CamHaoHa/tracker_leader_follower/example-code/images/hc-sr04.png

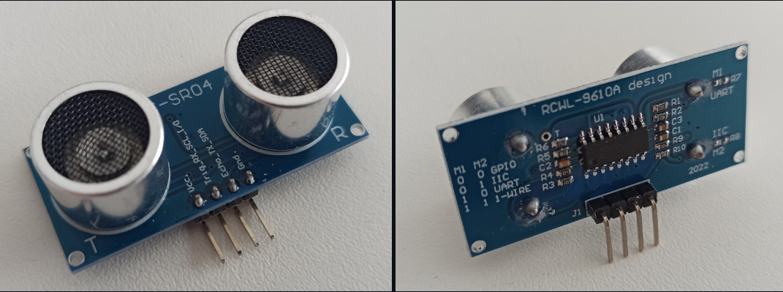
example-code/images/hc-sr04.png
