CamHaoHa/tracker_leader_follower/example-code/images/pico.png

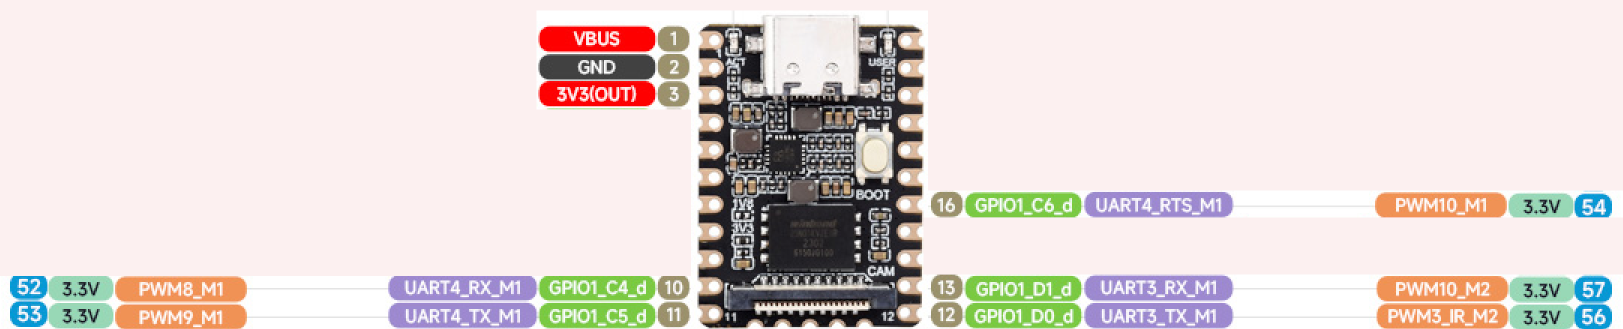
example-code/images/pico.png
