CamHaoHa/tracker_leader_follower/tools/README.md

# Sensor tools

## Prepare the Arduino IDE sketches

```bash
python3 -m tools.prepare_tracker_firmware
```

This writes one Arduino sketch folder per box position under
`firmware/arduino/`: `tracker_left`, `tracker_middle`, `tracker_right` and
`tracker_right_pair`. Each holds a copy of the maintained firmware and a private
`tracker_config.h`. Enter the phone hotspot's name and password there as
`WIFI_SSID` and `WIFI_PASSWORD`; the hotspot is the one supported network, so
there is no network option.

Running the command again refreshes the firmware copies and never overwrites an
existing `tracker_config.h`. Upload the sketches manually after any change. The
generator never connects to or flashes a board. Use `--check` to see whether the
generated files are current without writing anything.

See [live setup](../docs/live-tracker-setup.md) for joining the hotspot and
running the spot display.

## Record a real sensor test to Excel

Upload the Arduino `firmware/arduino/sensor_test/sensor_test.ino` sketch, then close
Serial Monitor and Serial Plotter. From the project root:

```bash
python3 -m tools.record_sensor_test --sensor A --distance-cm 25 --samples 30
```

This records USB serial measurements and saves a new timestamped folder under
`evidence/`, with an Excel report, CSV, original serial log, and metadata. The
distance argument is the measured true target gap, not a sensor command. See
[evidence instructions](../evidence/README.md) for port selection and partial runs.

## Jump benchmark (simulator)

```bash
python3 -m tools.jump_bench --csv results/jump-bench.csv --timeline
```

Times how fast the swarm tracker finds a player who jumps to another column, on
`config.prototype.json` in the built-in simulator: before the search after a
full loss, with it, and with a right or wrong `expect()` hint. It prints
Markdown tables (median, fastest and slowest of 20 jump moments); `--csv`
writes one row per trial and `--timeline` what each box does after one jump.
The numbers repeat exactly and say nothing about Wi-Fi delay or real echoes.
Recorded results: [jump benchmark, 2 October](../docs/jump-bench-2026-10-02.md).

## Standing benchmark (simulator)

```bash
python3 -m tools.stand_bench --csv results/stand-bench.csv
python3 -m tools.stand_bench --miss 0.3 --edge 0.6
```

How well the swarm tracker holds a player who stands still on each hole of
the game, in the field of 5 October 2026: that evening's arcs and empty-room
map, in which the outer boxes hear something about 0.6 m away (most likely
the middle box) at the inner ends of their arcs. The simulated boxes hear that
object where the map has it and, on some pings (`--edge`), up to 10 degrees
further in; and they miss the player on a share of pings (`--miss`). It
prints losses and cursor jumps per minute and the time on the hole for the
tracker before and after the change of 5 October. The echo model and both
rates are assumptions. Recorded results:
[standing benchmark, 5 October](../docs/stand-bench-2026-10-05.md).

## UDP sensor emulator

`simulate_nodes.py` runs two independent UDP endpoints with the same messages as the ESP32 firmware. Use it to exercise discovery, network acquisition, tracking, and disconnection without physical sensors:

```bash
python3 tools/simulate_nodes.py --x 0.75 --y 1.3 --seconds 60
```

The nodes bind `127.0.0.2:4211` and `127.0.0.3:4211`, and announce themselves to `127.0.0.1:4210`. Use the desktop application's normal hardware mode on the same computer; `--simulate` uses its separate in-process model and bypasses UDP. Run only one host and one copy of this emulator at a time.

The model uses sensors at `(0, 0.2)` and `(1.5, 0.2)` metres, 20° beam half angles, 60 ms + 3 ms/degree servo settling (maximum 700 ms), and bounded echo delay. It represents one ideal reflector and cannot establish real hardware accuracy or reliable detection of a moving person.

Options include `--empty` to return echo timeouts and `--drop-node 0` or `--drop-node 1` to suppress a node entirely. Ctrl+C stops the emulator. Its final JSON summary reports ping counts, the shortest interval between pings, and any overlapping acquisition commands.

The hardware path requires a background calibration. To exercise that workflow, start the emulator with `--empty --seconds 120`; in another terminal run:

```bash
python3 -m whack --headless --calibrate --seconds 90 --calibration /tmp/whack-udp-calibration.json
```

Stop the empty emulator, restart it with a reflector using the first command, then launch the visualizer with the same temporary profile:

```bash
python3 -m whack --calibration /tmp/whack-udp-calibration.json
```

Keep the simulator's profile separate from calibration captured with physical hardware. The temporary path above is suitable on Linux/macOS; choose a writable temporary path on Windows.

For an automated test, run:

```bash
python3 -m unittest discover -s tests -p 'test_udp.py' -v
```

The integration tests create their own temporary empty-scene profile, start the emulator as a subprocess, and verify discovery, position recovery, empty echoes, missing nodes, and expiration after disconnection. They use real loopback sockets; run outside a network-restricted sandbox if socket creation is denied.
