CamHaoHa/tracker_leader_follower/example-code/UPSTREAM.md

# Upstream provenance

This directory is a vendored, read-only copy of a third-party reference implementation.

- Upstream: https://github.com/themrleon/ultrasonic-2d-position-tracker
- Commit: 30b44d48dc3ab6ff51339cb5406505075d72c266 (2025-10-14T12:43:07-04:00)
- Licence: see LICENSE in this directory
- Vendored on: 2026-09-11

It is kept for study only. Do not modify files here; if changes are needed, copy the idea into this project's own code and cite the upstream file and line.
