CamHaoHa/tracker_leader_follower/example-code/images/demo.gif

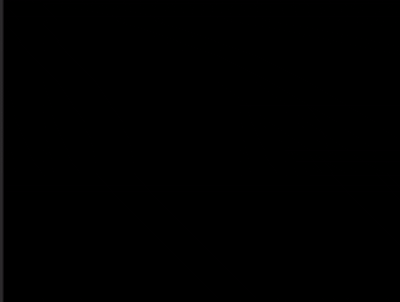
example-code/images/demo.gif
