CamHaoHa/tracker_leader_follower/results/report/reacquire_histogram.png

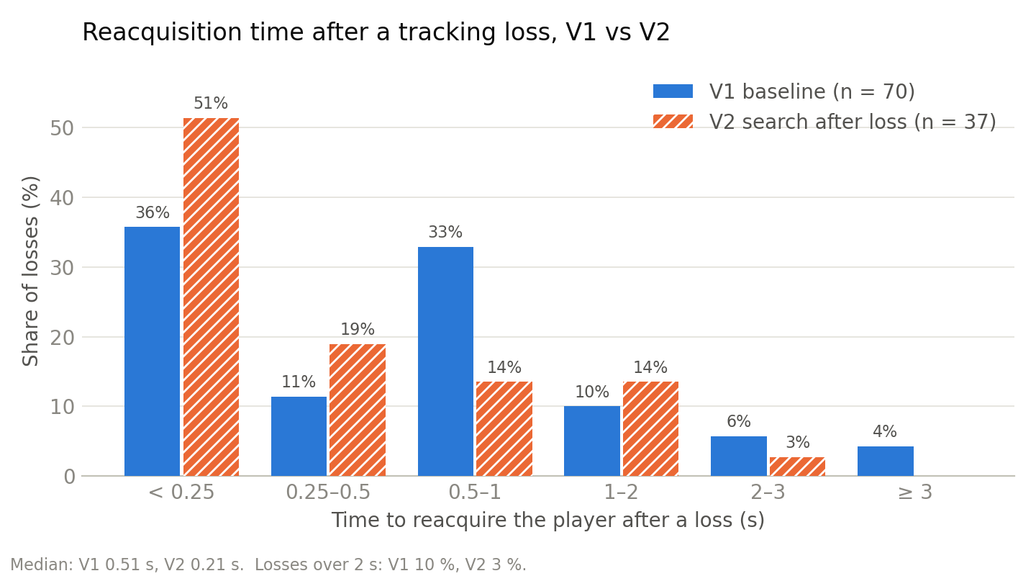
results/report/reacquire_histogram.png
