CamHaoHa/tracker_leader_follower/evidence/20260914_215239_sensor-A_25cm_32d13e63/results.xlsx

Sheet: Summary
Measure | Result
sensor | A
true_distance_cm | 25
requested_attempts | 30
started_at | 2026-09-14T21:52:39.410794+10:00
port | /dev/ttyUSB0
baud | 115200
capture_timeout_s | 60
startup_excluded_s | 2
notes
recorder_sha256 | a97a6e3836788a9964c5fdaa4a6315613b1148c47cfca23bae7fcd65e1e4d26a
uploaded_firmware | Not verified over serial; use Arduino sensor_test sketch.
finished_at | 2026-09-14T21:53:39.462816+10:00
capture_status | timeout
recorded_attempts | 0
numerical_returns | 0
no_echo | 0
echo_high | 0
out_of_range | 0
malformed | 0
return_rate
mean_cm
bias_cm
sample_sd_cm
min_cm
max_cm
mean_absolute_error_cm
Interpretation | Capture completion is not a reliability pass. Numerical returns may still be inaccurate.
Statistics | Statistics use READING rows only. Error statuses remain in the attempt counts and raw evidence.
Range filtering | This recorder does not impose a distance cap. OUT OF RANGE comes from the uploaded sketch.
Calibration | Bias is measured minus true distance. No correction is applied to the readings.
Raw evidence | serial.log preserves bytes received during capture; the final chunk can include extra uncounted lines.

Sheet: Readings
Sample | Received at | Status | Reading (cm) | True distance (cm) | Bias (cm) | Absolute error (cm) | Original serial line
