CamHaoHa/tracker_leader_follower/evidence/20260914_215543_sensor-A_25cm_cd1e33df/results.xlsx

Sheet: Summary
Measure | Result
sensor | A
true_distance_cm | 25
requested_attempts | 30
started_at | 2026-09-14T21:55:43.074206+10:00
port | /dev/ttyUSB0
baud | 115200
capture_timeout_s | 60
startup_excluded_s | 2
notes
recorder_sha256 | a97a6e3836788a9964c5fdaa4a6315613b1148c47cfca23bae7fcd65e1e4d26a
uploaded_firmware | Not verified over serial; use Arduino sensor_test sketch.
finished_at | 2026-09-14T21:55:58.094595+10:00
capture_status | complete
recorded_attempts | 30
numerical_returns | 30
no_echo | 0
echo_high | 0
out_of_range | 0
malformed | 0
return_rate | 1
mean_cm | 25.36333333
bias_cm | 0.3633333333
sample_sd_cm | 0.4055505694
min_cm | 24.5
max_cm | 26.3
mean_absolute_error_cm | 0.43
Interpretation | Capture completion is not a reliability pass. Numerical returns may still be inaccurate.
Statistics | Statistics use READING rows only. Error statuses remain in the attempt counts and raw evidence.
Range filtering | This recorder does not impose a distance cap. OUT OF RANGE comes from the uploaded sketch.
Calibration | Bias is measured minus true distance. No correction is applied to the readings.
Raw evidence | serial.log preserves bytes received during capture; the final chunk can include extra uncounted lines.

Sheet: Readings
Sample | Received at | Status | Reading (cm) | True distance (cm) | Bias (cm) | Absolute error (cm) | Original serial line
1 | 2026-09-14T21:55:43.325044+10:00 | READING | 25.10 | 25.00 | 0.10 | 0.10 | Distance: 25.1 cm | echo: 1466 us
2 | 2026-09-14T21:55:43.825805+10:00 | READING | 25.10 | 25.00 | 0.10 | 0.10 | Distance: 25.1 cm | echo: 1466 us
3 | 2026-09-14T21:55:44.326459+10:00 | READING | 24.60 | 25.00 | -0.40 | 0.40 | Distance: 24.6 cm | echo: 1432 us
4 | 2026-09-14T21:55:44.827020+10:00 | READING | 24.50 | 25.00 | -0.50 | 0.50 | Distance: 24.5 cm | echo: 1431 us
5 | 2026-09-14T21:55:45.327687+10:00 | READING | 25.50 | 25.00 | 0.50 | 0.50 | Distance: 25.5 cm | echo: 1484 us
6 | 2026-09-14T21:55:45.828469+10:00 | READING | 24.90 | 25.00 | -0.10 | 0.10 | Distance: 24.9 cm | echo: 1449 us
7 | 2026-09-14T21:55:46.329096+10:00 | READING | 26.30 | 25.00 | 1.30 | 1.30 | Distance: 26.3 cm | echo: 1536 us
8 | 2026-09-14T21:55:46.829464+10:00 | READING | 25.40 | 25.00 | 0.40 | 0.40 | Distance: 25.4 cm | echo: 1483 us
9 | 2026-09-14T21:55:47.329940+10:00 | READING | 25.50 | 25.00 | 0.50 | 0.50 | Distance: 25.5 cm | echo: 1484 us
10 | 2026-09-14T21:55:47.830552+10:00 | READING | 25.40 | 25.00 | 0.40 | 0.40 | Distance: 25.4 cm | echo: 1483 us
11 | 2026-09-14T21:55:48.331180+10:00 | READING | 25.50 | 25.00 | 0.50 | 0.50 | Distance: 25.5 cm | echo: 1484 us
12 | 2026-09-14T21:55:48.831776+10:00 | READING | 25.40 | 25.00 | 0.40 | 0.40 | Distance: 25.4 cm | echo: 1483 us
13 | 2026-09-14T21:55:49.332440+10:00 | READING | 25.50 | 25.00 | 0.50 | 0.50 | Distance: 25.5 cm | echo: 1484 us
14 | 2026-09-14T21:55:49.833106+10:00 | READING | 25.40 | 25.00 | 0.40 | 0.40 | Distance: 25.4 cm | echo: 1483 us
15 | 2026-09-14T21:55:50.333799+10:00 | READING | 26.00 | 25.00 | 1.00 | 1.00 | Distance: 26.0 cm | echo: 1518 us
16 | 2026-09-14T21:55:50.834433+10:00 | READING | 25.40 | 25.00 | 0.40 | 0.40 | Distance: 25.4 cm | echo: 1483 us
17 | 2026-09-14T21:55:51.335076+10:00 | READING | 25.50 | 25.00 | 0.50 | 0.50 | Distance: 25.5 cm | echo: 1484 us
18 | 2026-09-14T21:55:51.835631+10:00 | READING | 25.50 | 25.00 | 0.50 | 0.50 | Distance: 25.5 cm | echo: 1484 us
19 | 2026-09-14T21:55:52.336195+10:00 | READING | 26.00 | 25.00 | 1.00 | 1.00 | Distance: 26.0 cm | echo: 1518 us
20 | 2026-09-14T21:55:52.836753+10:00 | READING | 25.10 | 25.00 | 0.10 | 0.10 | Distance: 25.1 cm | echo: 1466 us
21 | 2026-09-14T21:55:53.337262+10:00 | READING | 25.20 | 25.00 | 0.20 | 0.20 | Distance: 25.2 cm | echo: 1467 us
22 | 2026-09-14T21:55:53.837999+10:00 | READING | 25.10 | 25.00 | 0.10 | 0.10 | Distance: 25.1 cm | echo: 1466 us
23 | 2026-09-14T21:55:54.338517+10:00 | READING | 25.10 | 25.00 | 0.10 | 0.10 | Distance: 25.1 cm | echo: 1466 us
24 | 2026-09-14T21:55:55.089676+10:00 | READING | 25.10 | 25.00 | 0.10 | 0.10 | Distance: 25.1 cm | echo: 1466 us
25 | 2026-09-14T21:55:55.590456+10:00 | READING | 25.20 | 25.00 | 0.20 | 0.20 | Distance: 25.2 cm | echo: 1467 us
26 | 2026-09-14T21:55:56.091230+10:00 | READING | 25.10 | 25.00 | 0.10 | 0.10 | Distance: 25.1 cm | echo: 1466 us
27 | 2026-09-14T21:55:56.591987+10:00 | READING | 25.10 | 25.00 | 0.10 | 0.10 | Distance: 25.1 cm | echo: 1466 us
28 | 2026-09-14T21:55:57.092809+10:00 | READING | 26.00 | 25.00 | 1.00 | 1.00 | Distance: 26.0 cm | echo: 1518 us
29 | 2026-09-14T21:55:57.593654+10:00 | READING | 25.40 | 25.00 | 0.40 | 0.40 | Distance: 25.4 cm | echo: 1483 us
30 | 2026-09-14T21:55:58.094528+10:00 | READING | 26.00 | 25.00 | 1.00 | 1.00 | Distance: 26.0 cm | echo: 1518 us
