CamHaoHa/tracker_leader_follower/evidence/20260914_215833_sensor-A_50cm_f1ec5aa8/results.xlsx

Sheet: Summary
Measure | Result
sensor | A
true_distance_cm | 50
requested_attempts | 30
started_at | 2026-09-14T21:58:33.720782+10:00
port | /dev/ttyUSB0
baud | 115200
capture_timeout_s | 60
startup_excluded_s | 2
notes
recorder_sha256 | a97a6e3836788a9964c5fdaa4a6315613b1148c47cfca23bae7fcd65e1e4d26a
uploaded_firmware | Not verified over serial; use Arduino sensor_test sketch.
finished_at | 2026-09-14T21:58:48.747902+10:00
capture_status | complete
recorded_attempts | 30
numerical_returns | 30
no_echo | 0
echo_high | 0
out_of_range | 0
malformed | 0
return_rate | 1
mean_cm | 54.62666667
bias_cm | 4.626666667
sample_sd_cm | 7.019722626
min_cm | 48
max_cm | 68
mean_absolute_error_cm | 5.373333333
Interpretation | Capture completion is not a reliability pass. Numerical returns may still be inaccurate.
Statistics | Statistics use READING rows only. Error statuses remain in the attempt counts and raw evidence.
Range filtering | This recorder does not impose a distance cap. OUT OF RANGE comes from the uploaded sketch.
Calibration | Bias is measured minus true distance. No correction is applied to the readings.
Raw evidence | serial.log preserves bytes received during capture; the final chunk can include extra uncounted lines.

Sheet: Readings
Sample | Received at | Status | Reading (cm) | True distance (cm) | Bias (cm) | Absolute error (cm) | Original serial line
1 | 2026-09-14T21:58:33.978423+10:00 | READING | 67.60 | 50.00 | 17.60 | 17.60 | Distance: 67.6 cm | echo: 3941 us
2 | 2026-09-14T21:58:34.479001+10:00 | READING | 67.20 | 50.00 | 17.20 | 17.20 | Distance: 67.2 cm | echo: 3916 us
3 | 2026-09-14T21:58:34.979514+10:00 | READING | 67.20 | 50.00 | 17.20 | 17.20 | Distance: 67.2 cm | echo: 3917 us
4 | 2026-09-14T21:58:35.480045+10:00 | READING | 67.20 | 50.00 | 17.20 | 17.20 | Distance: 67.2 cm | echo: 3916 us
5 | 2026-09-14T21:58:35.980625+10:00 | READING | 68.00 | 50.00 | 18.00 | 18.00 | Distance: 68.0 cm | echo: 3964 us
6 | 2026-09-14T21:58:36.481329+10:00 | READING | 63.40 | 50.00 | 13.40 | 13.40 | Distance: 63.4 cm | echo: 3698 us
7 | 2026-09-14T21:58:36.981866+10:00 | READING | 60.70 | 50.00 | 10.70 | 10.70 | Distance: 60.7 cm | echo: 3538 us
8 | 2026-09-14T21:58:37.482458+10:00 | READING | 59.00 | 50.00 | 9.00 | 9.00 | Distance: 59.0 cm | echo: 3438 us
9 | 2026-09-14T21:58:37.983091+10:00 | READING | 57.50 | 50.00 | 7.50 | 7.50 | Distance: 57.5 cm | echo: 3355 us
10 | 2026-09-14T21:58:38.483721+10:00 | READING | 56.60 | 50.00 | 6.60 | 6.60 | Distance: 56.6 cm | echo: 3298 us
11 | 2026-09-14T21:58:38.984347+10:00 | READING | 55.00 | 50.00 | 5.00 | 5.00 | Distance: 55.0 cm | echo: 3206 us
12 | 2026-09-14T21:58:39.484917+10:00 | READING | 54.80 | 50.00 | 4.80 | 4.80 | Distance: 54.8 cm | echo: 3196 us
13 | 2026-09-14T21:58:39.985611+10:00 | READING | 53.40 | 50.00 | 3.40 | 3.40 | Distance: 53.4 cm | echo: 3115 us
14 | 2026-09-14T21:58:40.486308+10:00 | READING | 51.50 | 50.00 | 1.50 | 1.50 | Distance: 51.5 cm | echo: 3003 us
15 | 2026-09-14T21:58:40.986938+10:00 | READING | 50.30 | 50.00 | 0.30 | 0.30 | Distance: 50.3 cm | echo: 2931 us
16 | 2026-09-14T21:58:41.487450+10:00 | READING | 50.30 | 50.00 | 0.30 | 0.30 | Distance: 50.3 cm | echo: 2932 us
17 | 2026-09-14T21:58:42.238632+10:00 | READING | 49.40 | 50.00 | -0.60 | 0.60 | Distance: 49.4 cm | echo: 2883 us
18 | 2026-09-14T21:58:42.739360+10:00 | READING | 49.00 | 50.00 | -1.00 | 1.00 | Distance: 49.0 cm | echo: 2860 us
19 | 2026-09-14T21:58:43.240029+10:00 | READING | 49.80 | 50.00 | -0.20 | 0.20 | Distance: 49.8 cm | echo: 2906 us
20 | 2026-09-14T21:58:43.740723+10:00 | READING | 50.30 | 50.00 | 0.30 | 0.30 | Distance: 50.3 cm | echo: 2931 us
21 | 2026-09-14T21:58:44.241440+10:00 | READING | 49.00 | 50.00 | -1.00 | 1.00 | Distance: 49.0 cm | echo: 2860 us
22 | 2026-09-14T21:58:44.742216+10:00 | READING | 49.50 | 50.00 | -0.50 | 0.50 | Distance: 49.5 cm | echo: 2884 us
23 | 2026-09-14T21:58:45.242766+10:00 | READING | 48.60 | 50.00 | -1.40 | 1.40 | Distance: 48.6 cm | echo: 2835 us
24 | 2026-09-14T21:58:45.743451+10:00 | READING | 49.40 | 50.00 | -0.60 | 0.60 | Distance: 49.4 cm | echo: 2883 us
25 | 2026-09-14T21:58:46.244219+10:00 | READING | 48.00 | 50.00 | -2.00 | 2.00 | Distance: 48.0 cm | echo: 2800 us
26 | 2026-09-14T21:58:46.744681+10:00 | READING | 48.60 | 50.00 | -1.40 | 1.40 | Distance: 48.6 cm | echo: 2835 us
27 | 2026-09-14T21:58:47.245471+10:00 | READING | 49.40 | 50.00 | -0.60 | 0.60 | Distance: 49.4 cm | echo: 2883 us
28 | 2026-09-14T21:58:47.746185+10:00 | READING | 49.20 | 50.00 | -0.80 | 0.80 | Distance: 49.2 cm | echo: 2871 us
29 | 2026-09-14T21:58:48.247013+10:00 | READING | 49.90 | 50.00 | -0.10 | 0.10 | Distance: 49.9 cm | echo: 2907 us
30 | 2026-09-14T21:58:48.747837+10:00 | READING | 49.00 | 50.00 | -1.00 | 1.00 | Distance: 49.0 cm | echo: 2859 us
