CamHaoHa/tracker_leader_follower/results/sensor-test-results.xlsx

Sheet: Read me
HC-SR04 sensor test results
Started | 2026-09-14
Current result | Sensor A: 25 cm recorded; first 50 cm run recorded but unstable (68 down to about 49 cm). Repeat fixed-target 50 cm run before calibration.
Purpose | Record accuracy, repeatability and missing readings for two sensors.
Hardware | Freenove ESP32-WROOM-32E; HC-SR04; TRIG GPIO32; ECHO GPIO35 through resistor divider.
Setup | One sensor active at a time, servo unpowered, sensor fixed and flat target facing it squarely.
True distance | Measure from front faces of metal transducers to target. All distances in centimetres.
Plan | Sensors A and B; 25, 50, 100, 150, 200 cm; 30 consecutive attempts at each distance.
Raw readings | Pre-filled IDs and sample numbers are planned slots, not completed measurements. Empty measurement cells mean no data.
Enter readings | Enter numerical distance in column E and READING in column F. Record errors in F with E blank.
Error statuses | NO ECHO; ECHO HIGH; OUT OF RANGE; OTHER ERROR. Preserve full serial messages in Notes.
Summary | Formulas calculate when opened in Excel. Numerical returns are not automatically accurate readings.
Statistics | Bias = measured minus true; MAE = average absolute error; SD = sample standard deviation.
Limits | No pass/fail threshold agreed. Flat-target tests do not establish body-tracking or servo-system reliability.
Conditions to record | Test date/time, sensor identity, supply voltage if measured, target dimensions, room temperature if known, resets.
Firmware | Updated sensor_test.ino: accepts 2-200 cm; rejected echoes report OUT OF RANGE. 115200 baud. Upload required.
Evidence | Raw runs retained under evidence/: 25 cm at 21:55:43; 50 cm at 21:58:33; earlier empty capture at 21:52:39.

Sheet: Raw readings
Test ID | Sensor | True distance (cm) | Sample | Reading (cm) | Status | Bias (cm) | Absolute error (cm) | Notes / original serial line
A-25-run1 | A | 25 | 1 | 25.10 | READING |  |  | 2026-09-14T21:55:43.325044+10:00 | Distance: 25.1 cm | echo: 1466 us | Source: 20260914_215543_sensor-A_25cm_cd1e33df
A-25-run1 | A | 25 | 2 | 25.10 | READING |  |  | 2026-09-14T21:55:43.825805+10:00 | Distance: 25.1 cm | echo: 1466 us | Source: 20260914_215543_sensor-A_25cm_cd1e33df
A-25-run1 | A | 25 | 3 | 24.60 | READING |  |  | 2026-09-14T21:55:44.326459+10:00 | Distance: 24.6 cm | echo: 1432 us | Source: 20260914_215543_sensor-A_25cm_cd1e33df
A-25-run1 | A | 25 | 4 | 24.50 | READING |  |  | 2026-09-14T21:55:44.827020+10:00 | Distance: 24.5 cm | echo: 1431 us | Source: 20260914_215543_sensor-A_25cm_cd1e33df
A-25-run1 | A | 25 | 5 | 25.50 | READING |  |  | 2026-09-14T21:55:45.327687+10:00 | Distance: 25.5 cm | echo: 1484 us | Source: 20260914_215543_sensor-A_25cm_cd1e33df
A-25-run1 | A | 25 | 6 | 24.90 | READING |  |  | 2026-09-14T21:55:45.828469+10:00 | Distance: 24.9 cm | echo: 1449 us | Source: 20260914_215543_sensor-A_25cm_cd1e33df
A-25-run1 | A | 25 | 7 | 26.30 | READING |  |  | 2026-09-14T21:55:46.329096+10:00 | Distance: 26.3 cm | echo: 1536 us | Source: 20260914_215543_sensor-A_25cm_cd1e33df
A-25-run1 | A | 25 | 8 | 25.40 | READING |  |  | 2026-09-14T21:55:46.829464+10:00 | Distance: 25.4 cm | echo: 1483 us | Source: 20260914_215543_sensor-A_25cm_cd1e33df
A-25-run1 | A | 25 | 9 | 25.50 | READING |  |  | 2026-09-14T21:55:47.329940+10:00 | Distance: 25.5 cm | echo: 1484 us | Source: 20260914_215543_sensor-A_25cm_cd1e33df
A-25-run1 | A | 25 | 10 | 25.40 | READING |  |  | 2026-09-14T21:55:47.830552+10:00 | Distance: 25.4 cm | echo: 1483 us | Source: 20260914_215543_sensor-A_25cm_cd1e33df
A-25-run1 | A | 25 | 11 | 25.50 | READING |  |  | 2026-09-14T21:55:48.331180+10:00 | Distance: 25.5 cm | echo: 1484 us | Source: 20260914_215543_sensor-A_25cm_cd1e33df
A-25-run1 | A | 25 | 12 | 25.40 | READING |  |  | 2026-09-14T21:55:48.831776+10:00 | Distance: 25.4 cm | echo: 1483 us | Source: 20260914_215543_sensor-A_25cm_cd1e33df
A-25-run1 | A | 25 | 13 | 25.50 | READING |  |  | 2026-09-14T21:55:49.332440+10:00 | Distance: 25.5 cm | echo: 1484 us | Source: 20260914_215543_sensor-A_25cm_cd1e33df
A-25-run1 | A | 25 | 14 | 25.40 | READING |  |  | 2026-09-14T21:55:49.833106+10:00 | Distance: 25.4 cm | echo: 1483 us | Source: 20260914_215543_sensor-A_25cm_cd1e33df
A-25-run1 | A | 25 | 15 | 26.00 | READING |  |  | 2026-09-14T21:55:50.333799+10:00 | Distance: 26.0 cm | echo: 1518 us | Source: 20260914_215543_sensor-A_25cm_cd1e33df
A-25-run1 | A | 25 | 16 | 25.40 | READING |  |  | 2026-09-14T21:55:50.834433+10:00 | Distance: 25.4 cm | echo: 1483 us | Source: 20260914_215543_sensor-A_25cm_cd1e33df
A-25-run1 | A | 25 | 17 | 25.50 | READING |  |  | 2026-09-14T21:55:51.335076+10:00 | Distance: 25.5 cm | echo: 1484 us | Source: 20260914_215543_sensor-A_25cm_cd1e33df
A-25-run1 | A | 25 | 18 | 25.50 | READING |  |  | 2026-09-14T21:55:51.835631+10:00 | Distance: 25.5 cm | echo: 1484 us | Source: 20260914_215543_sensor-A_25cm_cd1e33df
A-25-run1 | A | 25 | 19 | 26.00 | READING |  |  | 2026-09-14T21:55:52.336195+10:00 | Distance: 26.0 cm | echo: 1518 us | Source: 20260914_215543_sensor-A_25cm_cd1e33df
A-25-run1 | A | 25 | 20 | 25.10 | READING |  |  | 2026-09-14T21:55:52.836753+10:00 | Distance: 25.1 cm | echo: 1466 us | Source: 20260914_215543_sensor-A_25cm_cd1e33df
A-25-run1 | A | 25 | 21 | 25.20 | READING |  |  | 2026-09-14T21:55:53.337262+10:00 | Distance: 25.2 cm | echo: 1467 us | Source: 20260914_215543_sensor-A_25cm_cd1e33df
A-25-run1 | A | 25 | 22 | 25.10 | READING |  |  | 2026-09-14T21:55:53.837999+10:00 | Distance: 25.1 cm | echo: 1466 us | Source: 20260914_215543_sensor-A_25cm_cd1e33df
A-25-run1 | A | 25 | 23 | 25.10 | READING |  |  | 2026-09-14T21:55:54.338517+10:00 | Distance: 25.1 cm | echo: 1466 us | Source: 20260914_215543_sensor-A_25cm_cd1e33df
A-25-run1 | A | 25 | 24 | 25.10 | READING |  |  | 2026-09-14T21:55:55.089676+10:00 | Distance: 25.1 cm | echo: 1466 us | Source: 20260914_215543_sensor-A_25cm_cd1e33df
A-25-run1 | A | 25 | 25 | 25.20 | READING |  |  | 2026-09-14T21:55:55.590456+10:00 | Distance: 25.2 cm | echo: 1467 us | Source: 20260914_215543_sensor-A_25cm_cd1e33df
A-25-run1 | A | 25 | 26 | 25.10 | READING |  |  | 2026-09-14T21:55:56.091230+10:00 | Distance: 25.1 cm | echo: 1466 us | Source: 20260914_215543_sensor-A_25cm_cd1e33df
A-25-run1 | A | 25 | 27 | 25.10 | READING |  |  | 2026-09-14T21:55:56.591987+10:00 | Distance: 25.1 cm | echo: 1466 us | Source: 20260914_215543_sensor-A_25cm_cd1e33df
A-25-run1 | A | 25 | 28 | 26.00 | READING |  |  | 2026-09-14T21:55:57.092809+10:00 | Distance: 26.0 cm | echo: 1518 us | Source: 20260914_215543_sensor-A_25cm_cd1e33df
A-25-run1 | A | 25 | 29 | 25.40 | READING |  |  | 2026-09-14T21:55:57.593654+10:00 | Distance: 25.4 cm | echo: 1483 us | Source: 20260914_215543_sensor-A_25cm_cd1e33df
A-25-run1 | A | 25 | 30 | 26.00 | READING |  |  | 2026-09-14T21:55:58.094528+10:00 | Distance: 26.0 cm | echo: 1518 us | Source: 20260914_215543_sensor-A_25cm_cd1e33df
A-50-run1 | A | 50 | 1 | 67.60 | READING |  |  | 2026-09-14T21:58:33.978423+10:00 | Distance: 67.6 cm | echo: 3941 us | Source: 20260914_215833_sensor-A_50cm_f1ec5aa8
A-50-run1 | A | 50 | 2 | 67.20 | READING |  |  | 2026-09-14T21:58:34.479001+10:00 | Distance: 67.2 cm | echo: 3916 us | Source: 20260914_215833_sensor-A_50cm_f1ec5aa8
A-50-run1 | A | 50 | 3 | 67.20 | READING |  |  | 2026-09-14T21:58:34.979514+10:00 | Distance: 67.2 cm | echo: 3917 us | Source: 20260914_215833_sensor-A_50cm_f1ec5aa8
A-50-run1 | A | 50 | 4 | 67.20 | READING |  |  | 2026-09-14T21:58:35.480045+10:00 | Distance: 67.2 cm | echo: 3916 us | Source: 20260914_215833_sensor-A_50cm_f1ec5aa8
A-50-run1 | A | 50 | 5 | 68.00 | READING |  |  | 2026-09-14T21:58:35.980625+10:00 | Distance: 68.0 cm | echo: 3964 us | Source: 20260914_215833_sensor-A_50cm_f1ec5aa8
A-50-run1 | A | 50 | 6 | 63.40 | READING |  |  | 2026-09-14T21:58:36.481329+10:00 | Distance: 63.4 cm | echo: 3698 us | Source: 20260914_215833_sensor-A_50cm_f1ec5aa8
A-50-run1 | A | 50 | 7 | 60.70 | READING |  |  | 2026-09-14T21:58:36.981866+10:00 | Distance: 60.7 cm | echo: 3538 us | Source: 20260914_215833_sensor-A_50cm_f1ec5aa8
A-50-run1 | A | 50 | 8 | 59.00 | READING |  |  | 2026-09-14T21:58:37.482458+10:00 | Distance: 59.0 cm | echo: 3438 us | Source: 20260914_215833_sensor-A_50cm_f1ec5aa8
A-50-run1 | A | 50 | 9 | 57.50 | READING |  |  | 2026-09-14T21:58:37.983091+10:00 | Distance: 57.5 cm | echo: 3355 us | Source: 20260914_215833_sensor-A_50cm_f1ec5aa8
A-50-run1 | A | 50 | 10 | 56.60 | READING |  |  | 2026-09-14T21:58:38.483721+10:00 | Distance: 56.6 cm | echo: 3298 us | Source: 20260914_215833_sensor-A_50cm_f1ec5aa8
A-50-run1 | A | 50 | 11 | 55.00 | READING |  |  | 2026-09-14T21:58:38.984347+10:00 | Distance: 55.0 cm | echo: 3206 us | Source: 20260914_215833_sensor-A_50cm_f1ec5aa8
A-50-run1 | A | 50 | 12 | 54.80 | READING |  |  | 2026-09-14T21:58:39.484917+10:00 | Distance: 54.8 cm | echo: 3196 us | Source: 20260914_215833_sensor-A_50cm_f1ec5aa8
A-50-run1 | A | 50 | 13 | 53.40 | READING |  |  | 2026-09-14T21:58:39.985611+10:00 | Distance: 53.4 cm | echo: 3115 us | Source: 20260914_215833_sensor-A_50cm_f1ec5aa8
A-50-run1 | A | 50 | 14 | 51.50 | READING |  |  | 2026-09-14T21:58:40.486308+10:00 | Distance: 51.5 cm | echo: 3003 us | Source: 20260914_215833_sensor-A_50cm_f1ec5aa8
A-50-run1 | A | 50 | 15 | 50.30 | READING |  |  | 2026-09-14T21:58:40.986938+10:00 | Distance: 50.3 cm | echo: 2931 us | Source: 20260914_215833_sensor-A_50cm_f1ec5aa8
A-50-run1 | A | 50 | 16 | 50.30 | READING |  |  | 2026-09-14T21:58:41.487450+10:00 | Distance: 50.3 cm | echo: 2932 us | Source: 20260914_215833_sensor-A_50cm_f1ec5aa8
A-50-run1 | A | 50 | 17 | 49.40 | READING |  |  | 2026-09-14T21:58:42.238632+10:00 | Distance: 49.4 cm | echo: 2883 us | Source: 20260914_215833_sensor-A_50cm_f1ec5aa8
A-50-run1 | A | 50 | 18 | 49.00 | READING |  |  | 2026-09-14T21:58:42.739360+10:00 | Distance: 49.0 cm | echo: 2860 us | Source: 20260914_215833_sensor-A_50cm_f1ec5aa8
A-50-run1 | A | 50 | 19 | 49.80 | READING |  |  | 2026-09-14T21:58:43.240029+10:00 | Distance: 49.8 cm | echo: 2906 us | Source: 20260914_215833_sensor-A_50cm_f1ec5aa8
A-50-run1 | A | 50 | 20 | 50.30 | READING |  |  | 2026-09-14T21:58:43.740723+10:00 | Distance: 50.3 cm | echo: 2931 us | Source: 20260914_215833_sensor-A_50cm_f1ec5aa8
A-50-run1 | A | 50 | 21 | 49.00 | READING |  |  | 2026-09-14T21:58:44.241440+10:00 | Distance: 49.0 cm | echo: 2860 us | Source: 20260914_215833_sensor-A_50cm_f1ec5aa8
A-50-run1 | A | 50 | 22 | 49.50 | READING |  |  | 2026-09-14T21:58:44.742216+10:00 | Distance: 49.5 cm | echo: 2884 us | Source: 20260914_215833_sensor-A_50cm_f1ec5aa8
A-50-run1 | A | 50 | 23 | 48.60 | READING |  |  | 2026-09-14T21:58:45.242766+10:00 | Distance: 48.6 cm | echo: 2835 us | Source: 20260914_215833_sensor-A_50cm_f1ec5aa8
A-50-run1 | A | 50 | 24 | 49.40 | READING |  |  | 2026-09-14T21:58:45.743451+10:00 | Distance: 49.4 cm | echo: 2883 us | Source: 20260914_215833_sensor-A_50cm_f1ec5aa8
A-50-run1 | A | 50 | 25 | 48.00 | READING |  |  | 2026-09-14T21:58:46.244219+10:00 | Distance: 48.0 cm | echo: 2800 us | Source: 20260914_215833_sensor-A_50cm_f1ec5aa8
A-50-run1 | A | 50 | 26 | 48.60 | READING |  |  | 2026-09-14T21:58:46.744681+10:00 | Distance: 48.6 cm | echo: 2835 us | Source: 20260914_215833_sensor-A_50cm_f1ec5aa8
A-50-run1 | A | 50 | 27 | 49.40 | READING |  |  | 2026-09-14T21:58:47.245471+10:00 | Distance: 49.4 cm | echo: 2883 us | Source: 20260914_215833_sensor-A_50cm_f1ec5aa8
A-50-run1 | A | 50 | 28 | 49.20 | READING |  |  | 2026-09-14T21:58:47.746185+10:00 | Distance: 49.2 cm | echo: 2871 us | Source: 20260914_215833_sensor-A_50cm_f1ec5aa8
A-50-run1 | A | 50 | 29 | 49.90 | READING |  |  | 2026-09-14T21:58:48.247013+10:00 | Distance: 49.9 cm | echo: 2907 us | Source: 20260914_215833_sensor-A_50cm_f1ec5aa8
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
B-200-run1 | B | 200 | 20
B-200-run1 | B | 200 | 21
B-200-run1 | B | 200 | 22
B-200-run1 | B | 200 | 23
B-200-run1 | B | 200 | 24
B-200-run1 | B | 200 | 25
B-200-run1 | B | 200 | 26
B-200-run1 | B | 200 | 27
B-200-run1 | B | 200 | 28
B-200-run1 | B | 200 | 29
B-200-run1 | B | 200 | 30

Sheet: Summary
Test ID | Sensor | True distance (cm) | Recorded attempts | Numerical returns | NO ECHO | ECHO HIGH | Other errors | Return rate | Mean (cm) | Bias (cm) | SD (cm) | Min (cm) | Max (cm) | MAE (cm) | OUT OF RANGE
A-25-run1 | A | 25
A-50-run1 | A | 50
A-100-run1 | A | 100
A-150-run1 | A | 150
A-200-run1 | A | 200
B-25-run1 | B | 25
B-50-run1 | B | 50
B-100-run1 | B | 100
B-150-run1 | B | 150
B-200-run1 | B | 200

Sheet: Troubleshooting
Step | Observation | Evidence | Conclusion
1 | Python shared-library error in Arduino Snap; exit 255 | User screenshot | Build tool failed; no sensor measurement.
2 | Repeated ECHO already HIGH | User screenshots | Sketch running; input HIGH before measurement.
3 | HIGH persisted after sensor ECHO disconnected from A10 | User statement and screenshot | Sensor output disconnected; inspect board/divider/ground path.
4 | Direct GPIO35-to-GND diagnostic suggested | User said it works now; exact diagnostic output not supplied | Do not infer a specific diagnostic reading.
5 | Distance readings with sensor reconnected | User explicitly confirmed via reply | Basic ranging reported working; accuracy and reliability await numerical data.

Sheet: Calibration notes
Item | Recorded status
User request | Reject readings farther than 200 cm in the Arduino bench test.
Implementation | Accept computed 2-200 cm inclusive; OUT OF RANGE otherwise. No fabricated 200 cm replacement for rejected distances.
Calibration status | Not calibrated: no actual known-distance readings supplied.
Project geometry | Far boundary is 200 cm from wall; default opposite sensor-to-corner distance is approximately 234 cm.
Scope | 200 cm cap applies to standalone Arduino sensor test. Full tracker node firmware retains its existing range limits.
Boundary bias | At true 200 cm, positive measurement errors can be rejected. Keep these counts; use an uncapped diagnostic run if needed to estimate bias.
Next measurements | 30 consecutive lines at each measured distance, sensor identity, target size, and power/temperature conditions if available.
Bench upload status | Updated sketch has not been confirmed uploaded to the physical board.
Measured at 25 cm | Sensor A: 30/30 returns; mean 25.3633 cm; bias +0.3633 cm; SD 0.4056 cm; MAE 0.43 cm. No calibration correction applied; collect more distances first.
50 cm run 1: repeat needed | 30/30 numerical returns; mean 54.6267 cm, bias +4.6267 cm, SD 7.0197 cm, range 48–68 cm, MAE 5.3733 cm. Readings trend downward during capture; target movement or changing reflection is possible, not confirmed. No correction applied.
