CamHaoHa/tracker_leader_follower/firmware/include/settings.h

#pragma once

#ifndef NODE_ID
#error "Build node_left, node_middle or node_right (node_right_pair for two boxes) to select NODE_ID"
#endif

#if __has_include("config.local.h")
#include "config.local.h"
#endif

// Network profiles were removed on 2026-10-01. A private config that still
// carries one of their settings would otherwise build and join whatever
// WIFI_SSID happens to hold, so stop the build and name the fix instead.
#if defined(WIFI_PROFILE) || defined(SCHOOL_WIFI_SSID) || defined(SCHOOL_WIFI_PASSWORD) || \
    defined(TRACKER_WIFI_SSID) || defined(TRACKER_WIFI_PASSWORD) || defined(TRACKER_WIFI_CHANNEL) || \
    defined(ONENET_SSID) || defined(ONENET_USERNAME) || defined(ONENET_PASSWORD) || \
    defined(ONENET_SERVER_DOMAIN) || defined(ONENET_BUILD_TIMEZONE)
#error "Network profiles were removed: put the phone hotspot name and password in WIFI_SSID / WIFI_PASSWORD and delete the WIFI_PROFILE, SCHOOL_WIFI_*, TRACKER_WIFI_* and ONENET_* lines from your private config"
#endif

// The one network: a phone hotspot (WPA2-personal, 2.4 GHz) that the laptop
// and every box join. An empty name builds, but the board reports missing
// credentials over USB and never tries to connect.
#ifndef WIFI_SSID
#define WIFI_SSID ""
#endif
#ifndef WIFI_PASSWORD
#define WIFI_PASSWORD ""
#endif
#ifndef SERVO_REVERSED
#define SERVO_REVERSED 0
#endif
#ifndef SERVO_CENTER_TRIM_MDEG
#define SERVO_CENTER_TRIM_MDEG 0
#endif
#ifndef SERVO_PULSE_MIN_US
#define SERVO_PULSE_MIN_US 1000
#endif
#ifndef SERVO_PULSE_MAX_US
#define SERVO_PULSE_MAX_US 2000
#endif
#ifndef SERVO_MIN_MDEG
#define SERVO_MIN_MDEG 0
#endif
#ifndef SERVO_MAX_MDEG
#define SERVO_MAX_MDEG 180000
#endif
// One pin map for every box: servo signal GPIO33, TRIG GPIO32, ECHO GPIO34.
// GPIO34 is input-only and has no internal pull resistors. The sensor is
// powered from 3V3, so ECHO is a 3.3 V signal wired directly (no divider).
#ifndef SERVO_PIN
#define SERVO_PIN 33
#endif
#ifndef ULTRASONIC_TRIG_PIN
#define ULTRASONIC_TRIG_PIN 32
#endif
#ifndef ULTRASONIC_ECHO_PIN
#define ULTRASONIC_ECHO_PIN 34
#endif
// Optional buzzer, sounded by the laptop with WM2 BUZZ. -1 = this box has none
// and ignores the command. Only the middle box (node 1) carries one, on GPIO25.
#ifndef BUZZER_PIN
#define BUZZER_PIN -1
#endif
// Square-wave frequency for a passive buzzer. 0 = hold the pin steadily HIGH
// while sounding, for an active buzzer that has its own oscillator.
#ifndef BUZZER_TONE_HZ
#define BUZZER_TONE_HZ 2000
#endif
#ifndef SERVO_SETTLE_MIN_MS
#define SERVO_SETTLE_MIN_MS 60
#endif
#ifndef SERVO_SETTLE_MS_PER_DEG
#define SERVO_SETTLE_MS_PER_DEG 3
#endif
#ifndef SERVO_SETTLE_MAX_MS
#define SERVO_SETTLE_MAX_MS 700
#endif
#ifndef ULTRASONIC_TIMEOUT_US
#define ULTRASONIC_TIMEOUT_US 25000
#endif
#ifndef ULTRASONIC_MIN_GAP_MS
#define ULTRASONIC_MIN_GAP_MS 65
#endif

static_assert(NODE_ID >= 0 && NODE_ID <= 9, "NODE_ID must be 0..9: the wire protocol carries one digit");
// A network name is at most 32 bytes; the typographic apostrophe in an iPhone
// name counts as three (\xE2\x80\x99).
static_assert(sizeof(WIFI_SSID) - 1 <= 32, "WIFI_SSID must be at most 32 bytes");
static_assert(SERVO_REVERSED == 0 || SERVO_REVERSED == 1,
              "SERVO_REVERSED must be 0 or 1");
static_assert(SERVO_MIN_MDEG >= 0 && SERVO_MAX_MDEG <= 180000 &&
                  SERVO_MIN_MDEG < SERVO_MAX_MDEG,
              "Servo travel limits must be within 0..180000");
static_assert(SERVO_CENTER_TRIM_MDEG >= -90000 && SERVO_CENTER_TRIM_MDEG <= 90000,
              "Trim must be within +/-90 degrees");
static_assert(SERVO_PULSE_MIN_US >= 500 && SERVO_PULSE_MAX_US <= 2500 &&
                  SERVO_PULSE_MIN_US < SERVO_PULSE_MAX_US,
              "Servo pulse endpoints must be within 500..2500 us");
static_assert(SERVO_SETTLE_MIN_MS >= 60 && SERVO_SETTLE_MS_PER_DEG >= 0 &&
                  SERVO_SETTLE_MAX_MS >= SERVO_SETTLE_MIN_MS &&
                  SERVO_SETTLE_MAX_MS <= 700,
              "Settling must stay within 60..700 ms");
static_assert(ULTRASONIC_TIMEOUT_US > 0 && ULTRASONIC_TIMEOUT_US <= 25000,
              "Echo timeout must be bounded at 25 ms");
static_assert(ULTRASONIC_MIN_GAP_MS >= 65, "Leave at least 65 ms between pings");
static_assert(SERVO_PIN != ULTRASONIC_TRIG_PIN && SERVO_PIN != ULTRASONIC_ECHO_PIN &&
                  ULTRASONIC_TRIG_PIN != ULTRASONIC_ECHO_PIN,
              "Servo, trigger and echo must use distinct pins");
// GPIO1 and GPIO3 are the USB serial port and GPIO6..11 are wired to the
// module's flash chip: a buzzer on any of them stops the board from running.
static_assert(BUZZER_PIN == -1 ||
                  (BUZZER_PIN >= 0 && BUZZER_PIN <= 33 && BUZZER_PIN != 1 && BUZZER_PIN != 3 &&
                   !(BUZZER_PIN >= 6 && BUZZER_PIN <= 11)),
              "BUZZER_PIN must be -1 (no buzzer) or a free output pin: not GPIO1/GPIO3 (serial), "
              "GPIO6..11 (flash) or GPIO34..39 (input-only)");
static_assert(BUZZER_PIN < 0 || (BUZZER_PIN != SERVO_PIN && BUZZER_PIN != ULTRASONIC_TRIG_PIN &&
                                 BUZZER_PIN != ULTRASONIC_ECHO_PIN),
              "The buzzer must not share a pin with the servo, trigger or echo");
static_assert(BUZZER_TONE_HZ == 0 || (BUZZER_TONE_HZ >= 100 && BUZZER_TONE_HZ <= 10000),
              "BUZZER_TONE_HZ must be 0 (steady HIGH, active buzzer) or 100..10000");
