CamHaoHa/tracker_leader_follower/(commit log)

2026-09-11 feat: add coordinated ESP32 sensor and servo firmware
2026-09-22 feat: coordinated live tracker, TrackerNet profiles and field test docs
    Imports the work that sat uncommitted in the main checkout since
    15 September 2026, unchanged:
    - WM2 AIM / READY / FIRE / RANGE protocol with one-use firing leases; the
    laptop schedules both pingers so the two transmitters never overlap
    - Wi-Fi profiles 0-3 including TrackerNet, a WPA2 access point hosted by
    the left ESP32; Arduino sketch generator (tools/prepare_tracker_firmware)
    that keeps per-board credentials and servo settings
    - Freenove ESP32-WROOM-32E pin map (servo GPIO25, TRIG GPIO32, ECHO GPIO35)
    and the SG90 500-2500 us mapping from the half-angle measurement
    - Controller state machine: calibration ->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
    [results.xlsx, sensor-test-results.xlsx]
2026-09-22 feat: bench-proven tracking: robust calibration, smooth servos, body model, operator UI
    First full bench session with both physical boxes, 22 September 2026.
    Before/after numbers are in docs/mvp1-bench-log-2026-09-22.md and can be
    reproduced with `python3 -m tools.session_metrics results/*.csv`.
    Controller (whack/controller.py)
    - Re-request a lost READY every 0.3 s instead of failing the frame
    - Calibration tolerates three failed frames per step, skips bearings a
    servo cannot reach, and survives the HC-SR04 no-echo hold-off: an
    age-0 INVALID means "ECHO still high", so the same aim is retried
    - Search visits targets along a minimal-swing path (mean step 12-14 deg
    instead of field-wide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
    [main.cpp, session_metrics.py, test_controller.py, test_tracking.py, test_ui.py]
2026-09-22 docs: add README_1.html, an illustrated explainer of the two-servo tracker
    Self-contained page for the project owner: who decides what, one AIM /
    READY / FIRE / RANGE cycle, how two servos agree (one target point, two
    bearings, one sequence number), two-range circle intersection with the
    body-radius model and its four acceptance gates, the controller state
    machine (idle -> calibration -> find -> confirm -> track -> local_search
    -> lost), search ordering and calibration sweeps, the firmware firing
    lease and servo ramp, the mirrored grid display, and the 22 September
    bench numbers. Code blocks are extracted verbatim from the source.
2026-09-23 tracking: keep a confirm candidate through misses, 1 s recovery window, reason column
    University bench, 23 Sep: with the boxes 1.5 m apart the right sensor
    returned the player only on every other ping, and one missed pair threw
    the candidate away (confirm -> find) or ended the track (0.5 s window
    was a single frame). Now a confirm candidate survives misses for
    local_search_s, the second confirming pair may arrive within that same
    window, local_search_s defaults to 1.0 s in the configs, and the FIRE
    reply timeout is 0.4 s for hotspot latency. The CSV gains a "reason"
    column with the tracker's accept/reject reason for post-run diagnosis.
2026-09-23 plumbing: allow more than two boxes in protocol, geometry, transport and CLI
    Groundwork for the leader-follower tracker. Node IDs 0-9 in the wire
    protocol; Geometry gains extra_sensor_x, per-box sweep bounds, sweep
    step, reliable range, minimum player range, background margin, jitter
    and two-player separation settings, with sensor_x()/sensor_position()
    helpers; UdpTransport accepts any number of distinct node addresses;
    SimulatedTransport sizes itself from the geometry; --nodes takes a list.
    Behaviour with two boxes is unchanged.
    [test_protocol.py]
2026-09-23 swarm: independent-sweep, leader-follower tracker for N boxes (whack/swarm.py)
    Each box sweeps its own arc in 5-degree steps (snapping to the grid,
    bouncing at its bounds) with one ping per bearing; pings stay serialised
    with the 65 ms guard. A reliable echo (OK, 0.10-1.7 m, nearer than the
    empty-room map, repeated within 10 cm) gives a polar estimate and every
    other box is aimed at it at once. Boxes that also see the player refine
    the fix by least-squares over their range circles; a lone box keeps a
    coarse polar fix shown as a hollow dot. A box that finds nothing at the
    estimate jitters +/-8 degrees for a second, then resumes its sweep and
    is not re-aimed at the same spot for 2 s. Alerts fo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
    [test_swarm.py, test_ui.py]
2026-09-23 swarm: dead-zone alert, one-box fixes need a wide margin before "outside"
    First live runs with the leader-follower tracker on the 1.5 m field
    (two boxes, hotspot): 93 % and 89 % dot coverage over 136 s and 58 s
    of walking, 4.0-4.4 fresh fixes/s, reacquire 0.4-0.5 s median. The
    run showed "outside the field" firing from one-box polar fixes that
    poke past an edge; now a one-box fix must be 0.4 m outside, a two-box
    fix 0.1 m. Entering the 10 cm dead zone raises "Player in the dead
    zone" (strict for two-box fixes). The far edge is beyond the 1.7 m
    reliable range with 1.5 m spacing, so leaving past it is not
    detectable; documented in the tests.
    [test_swarm.py]
2026-09-23 swarm: drop prediction, the spot is the last measured point
    Leader-follower aims every box at the last fused point and re-aims when it
    moves 0.3 m, so extrapolating along a velocity estimated from noisy one-box
    fixes only pushed the aim off. Replace the alpha-beta Motion filter with
    Estimate: smoothing (smoothing_tau_s, half weight for one-box fixes) plus the
    max_speed_m_s jump reject, no velocity, no extrapolation.
    Hollow spot now means "one box only"; solid means both boxes agreed within
    0.30 m. Confidence fades over local_search_s. aim_lead_s and
    prediction_horizon_s are no longer read by the swarm tracker (pairs still
    uses them). UI diagnostics wording and the two affected tests updated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
    [test_swarm.py, test_ui.py]
2026-09-24 docs: day-2 bench log, 1.5 m field at university with the swarm tracker
    Timeline from the paired tracker failing at 1.5 m spacing (dot 14 %) through
    the leader-follower redesign, the false-alert fix, straightening box 1, and
    removing prediction. Per-segment metrics with two-box agreement and per-node
    echo rates; box 0 echo rate by distance before and after its USB re-plug;
    how the boxes agree on one target; next steps (box 0 check, servo power,
    centre box, follower confirmation).
2026-09-28 firmware: third box, node_middle env with NODE_ID 2
    settings.h accepts NODE_ID 0..9 (the wire protocol carries one digit);
    platformio.ini gains node_middle; the Arduino generator also emits
    tracker_middle. Docs name the ELEGOO ESP-WROOM-32 (CP2102) as a
    drop-in board with the same GPIO map.
2026-09-28 firmware: standalone servo + HC-SR04 bench sketch
    Sweeps 60-120 deg in 10 deg steps with three pings per stop and prints
    every move and range on USB serial; accepts aim/ping/sweep commands.
    Verified on an ELEGOO board: servo moved, ranges 5-191 cm.
2026-09-28 firmware: name builds by box position (left 0, middle 1, right 2)
    The laptop numbers boxes left to right by x, so the middle box of three
    is node 1. node_middle now builds NODE_ID 1 and node_right NODE_ID 2.
    node_right_pair keeps NODE_ID 1 for the right box of a two-box layout.
    The Arduino generator emits the same four sketch folders.
2026-09-28 tools: probe_node accepts node IDs 0..9 for the third box
2026-09-29 swarm: clamp aims to the servo travel instead of 0..180
    Field run 4 (three boxes, 29 Sep): 9 % of node 0's and 14-15 % of node 2's
    AIM commands came back 'bearing outside servo travel' because the laptop
    asked for angles past the SG90's 30..150 deg limit whenever the player was
    near that box's own edge; each refusal cost a ping. Geometry gains
    servo_travel_deg (default 0..180, the bench boxes set 30..150): aims are
    clamped into it and the default sweep arcs are clipped to it, explicit
    arcs outside it are rejected at load time.
2026-09-29 pins: servo GPIO33, TRIG GPIO32, ECHO GPIO34 on every box
    The boxes are being rewired to one shared pin map: servo signal on
    GPIO33, ultrasonic TRIG on GPIO32 and ECHO on GPIO34. The sensors are
    powered from 3V3, so ECHO is a 3.3 V signal wired directly and the
    divider is gone. GPIO34 is input-only with no internal pull resistors.
    GPIO25 is freed for the middle box's buzzer.
    This replaces servo 25 / ECHO 35 wherever it was a default or a current
    instruction: the settings.h defaults, config.example.h, the
    tracker_config.h template in tools/prepare_tracker_firmware.py, the
    bench_test and sensor_test sketches, the boot banner, and the wiring
    sections of README.md, firmware/README.md, docs/live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
    [bench_test.ino, config.example.h, main.cpp, prepare_tracker_firmware.py, sensor_test.ino, settings.h]
2026-09-29 firmware: optional buzzer on GPIO25 and the WM2 BUZZ command
    The middle box (node 1) gets a buzzer on GPIO25 so the game can warn a
    player who is too close to the wall. Every other box has none.
    BUZZER_PIN is optional and defaults to -1. config.example.h sets it to
    25 under "#if NODE_ID == 1", and the generated tracker_middle sketch
    config sets it too. BUZZER_TONE_HZ (default 2000) is the square wave
    for a passive buzzer; 0 holds the pin HIGH for an active buzzer.
    static_asserts reject a buzzer pin that is input-only or shared with
    the servo, trigger or echo.
    The tone uses LEDC channel 2 at 10 bits, 50 % duty while sounding and
    duty 0 when silent. Core 2.x pairs channels on timers (0+1, 2+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
    [config.example.h, main.cpp, prepare_tracker_firmware.py, protocol_test.cpp, settings.h, test_prepare_tracker_firmware.py, wm_protocol.h]
2026-09-29 swarm: sound the buzzer box during a near-wall alert
    The laptop now drives the middle box's buzzer so a player who walks
    into the dead zone or up to a box hears it, not only sees the banner.
    protocol.py gains buzz(duration_ms) -> b"WM2 BUZZ <n>", bounded to
    0..2000 like the firmware parser. Geometry gains buzzer_node (-1 = no
    buzzer), validated as -1 or a node index. It is not one of the layout
    fields that gate a saved calibration, so naming the buzzer box keeps
    the existing map valid.
    SwarmController sends buzz(400) to that box every 0.2 s while the
    alert is "Player in the dead zone" or "Player too close to box n", the
    controller is neither paused nor calibrating, and the box is online
    wi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
    [simulate_nodes.py, test_node_simulator.py, test_protocol.py, test_swarm.py, test_transport.py]
2026-09-29 docs: buzzer wiring and behaviour, changelog for 2026-09-29
    docs/live-tracker-setup.md gets a Buzzer section: buzzer + to GPIO25 of
    the middle box and - to GND, which alerts sound it, the failsafe (the
    box silences itself at its deadline, at most 2 s per command), and
    BUZZER_TONE_HZ 0 for an active buzzer. It also gives a one-line manual
    test that sends one BUZZ from UDP 4210.
    The README pin table and the setup guide's pin table list the buzzer
    pin. firmware/README.md no longer says there are no warning sounds.
    docs/CHANGELOG.md gets a dated entry for the shared pin map and the
    buzzer. It states what was checked without hardware and that nothing
    has been flashed or run on the boxes yet. Ol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
2026-09-29 swarm: drop a too-close report when its box stops reporting
    "Player too close to box n" was withdrawn only by a later reading from
    the same box. A box that went offline or lost its replies never sent
    one, so the alert stayed up and the laptop kept sending BUZZ 400: in
    the simulator the buzzer was still being driven 30 s after the player
    had stepped back. The box's own 2 s failsafe cannot help while the
    laptop keeps asking.
    A report is now dropped when its box is not online or has reported
    nothing for 1.5 s (TOO_CLOSE_STALE_S), and pause() forgets all reports,
    so Resume no longer sounds for a player who stepped back during the
    pause. A box that keeps reporting keeps the alert as before.
    Tes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
    [test_swarm.py]
2026-09-29 swarm: retry a failed BUZZ at the BUZZ interval, not on every poll
    buzz_sent_at was updated only when the send succeeded, so while the
    network was down every poll tried again: about 100 failed sendto calls
    a second at the 10 ms test poll, one per frame in the UI. Nothing
    escaped poll() and tracking carried on, so this was only wasted work.
    buzz_sent_at is now the time of the last attempt, sent or not. When
    the alert ends it is reset whether or not the buzzer ever sounded, so
    the next alert still sounds without delay.
    Tests: failed sends are 0.2 s apart; a send that recovers sounds at
    the next interval.
    [test_swarm.py]
2026-09-29 firmware: refuse a buzzer on the serial and flash pins
    The BUZZER_PIN range check accepted every pin 0..33. That includes
    GPIO1 and GPIO3, the USB serial port, and GPIO6..11, which are wired to
    the module's flash chip: a build with the buzzer on one of those would
    flash but not run. The configured pin, 25, was never affected; this
    only catches a wrong value typed into config.local.h.
    Checked with the host compiler: -1, 25 and the other free output pins
    pass; 1, 3, 6..11, 34..39 and the servo, trigger and echo pins fail
    the build with a message naming the reason.
    [settings.h]
2026-09-29 tools: probe_node --buzz sounds the buzzer during the pings
    Whether the sounding buzzer disturbs the middle box's own HC-SR04 has
    not been measured, and it could not be measured with the existing
    tools: the probe and the one-line BUZZ command both need UDP 4210, so
    they cannot run at the same time.
    --buzz sends WM2 BUZZ 2000 before every ping, so the sound lasts for
    the whole run, and BUZZ 0 at the end. A run with it and a run without
    it, at the same target, show whether the ranges change. Without the
    option the probe sends exactly what it sent before.
    main() takes argv so the test can call it. The test runs the probe
    against a stand-in node on 127.0.0.2.
    [probe_node.py, test_probe_node.py]
2026-09-29 docs: buzzer follow-up, bench check and changelog
    - A box that prints no "Buzzer:" line at boot runs firmware from before
    the buzzer and drops WM2 BUZZ silently. Say so, and say that the
    middle box needs the current build: a pins-only build is enough for
    the other boxes but never sounds.
    - The bench check for the one risk that only hardware can answer:
    whether the sound changes the middle box's own ranges. It uses
    probe_node --buzz.
    - The two build paths differ for a two-box right box: PlatformIO
    node_right_pair is node 1 and drives GPIO25, the generated
    tracker_right_pair sketch has no buzzer. Documented in both guides
    and next to the generator template; behaviour is unchang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
    [prepare_tracker_firmware.py]
2026-09-29 firmware: upload at 115200 baud
    The esp32doit-devkit-v1 default of 460800 fails on the ELEGOO CP2102
    boards after the baud switch with 'Unable to verify flash chip
    connection (No serial data received.)'. PLATFORMIO_UPLOAD_SPEED is not
    a setting PlatformIO reads, so the speed has to live here.
2026-10-01 config: tracked three-box field config for the prototype
    The three-box prototype's field setup (three sensors at x 0, 0.75 and
    1.5 m, sensor line at y 0.5 m, full 0..180 servo travel, buzzer on the
    middle box) existed only in the gitignored config.local.json, so a fresh
    clone on another computer could not run the prototype. It holds no
    secrets, so it now travels with the repository as config.prototype.json.
    The CLI default is unchanged: no --config still means the built-in
    two-box geometry. A test loads the file through load_geometry and checks
    that the simulated swarm tracks a player in the middle of the field.
    [test_prototype_config.py]
2026-10-01 firmware: join the phone hotspot only
    The boxes are only ever used on a phone hotspot now, so the four network
    profiles are reduced to one ordinary WPA2-personal station connection.
    Removed: WIFI_PROFILE and every profile branch, the SCHOOL_WIFI_*,
    ONENET_* and TRACKER_WIFI_* settings, the WPA2-Enterprise/PEAP code with
    its certificate clock and NTP call, the soft access point that node 0
    ran for TrackerNet, and every NODE_ID == 0 networking special case.
    What remains: WiFi.mode(WIFI_STA), WiFi.begin(WIFI_SSID, WIFI_PASSWORD),
    the existing 10 s reconnect attempt, WL_CONNECTED as the availability
    test and WiFi.localIP()/subnetMask() for the HELLO broadcast address.
    The boot banner names the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
2026-10-01 tools: sketch generator without network selection; drop probe_network
    The firmware has one network now, so the Arduino IDE sketch generator no
    longer chooses one. Removed the --network option, the generated
    tracker_network.h override and the tracker_network.local.json password
    file for TrackerNet. tracker_node.cpp includes only tracker_config.h,
    and the config template carries the same single Wi-Fi block as
    config.example.h (phone hotspot, WIFI_SSID / WIFI_PASSWORD). Refreshing
    still never overwrites an existing tracker_config.h.
    Tests for the removed network files are deleted; the rest are adapted,
    and new ones check that no network override is generated and that
    --network is rejected.
    to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
2026-10-01 docs: one phone hotspot, prototype run command, run on another computer
    The instructions still described four network profiles, TrackerNet with
    the left board as access point, and the deferred OneNet setup. All of
    that is gone from the firmware and the generator, so the READMEs and
    guides now describe the one supported network: a WPA2-personal phone
    hotspot on 2.4 GHz that the laptop and every box join, with the boxes
    found by their HELLO broadcast (laptop UDP 4210, boxes UDP 4211).
    The three-box prototype is started everywhere with
    python3 -m whack --tracker swarm --config config.prototype.json
    and --nodes is documented as an optional override for a network that
    blocks broadcast. The REA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
2026-10-01 firmware: stop the build when a removed network profile setting remains
    A private config.local.h or tracker_config.h written for the old profiles
    (WIFI_PROFILE with SCHOOL_WIFI_*, TRACKER_WIFI_* or ONENET_*) still compiled
    with no diagnostic, and the board then joined whatever WIFI_SSID held: the
    old home entry, a placeholder or nothing. Every config made from the old
    example or the old generator template defines WIFI_PROFILE, so settings.h
    now raises an #error naming the fix while any removed name is defined. The
    guard is preprocessor only and leaves the image unchanged (node_left stays
    at 745821 bytes).
    tests/test_firmware_settings.py compiles a copy of settings.h with the host
    g++ (skipp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
    [settings.h, test_firmware_settings.py]
2026-10-01 tests: name the DHCP-change discovery test after what it checks
    The test was called test_softap_discovery_... and used 192.168.4.x, the
    address range of the TrackerNet access point that node 0 no longer runs. It
    exercises DHCP reassignment and conflicting identities in the HELLO
    discovery, which applies to the phone hotspot just the same, so it keeps
    its assertions and gets a neutral name and hotspot-style addresses. The
    socket is patched and the test asserts that nothing is sent.
    whack/transport.py is untouched.
    [test_transport.py]
2026-10-01 docs: controls, scan steps and sensor line as the swarm prototype behaves
    Review findings on the current instructions:
    - "Space / R restarts acquisition" was wrong: the window binds Space to
    search, P to pause/resume and R to reset, and reset leaves both trackers
    paused. Fixed in the README controls table and in the setup, first-test,
    workflow, architecture, code-guide and firmware guides.
    - The live setup guide's "Start the screen and empty-area scan" steps still
    described the paired tracker: no Space after calibration and a
    --start-mode hint that the swarm tracker ignores. They now follow the
    swarm window, which waits for Space once the calibration is saved.
    - The (0, 0.20)/(1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
2026-10-02 tracker: search after a full loss instead of jittering, optional mole hint
    When the player skipped a column (mole at column 1, then column 3) the swarm
    tracker needed seconds to find them again. All three boxes were aimed at the
    old spot and missed together; each then dithered +-8 degrees round that empty
    spot for jitter_s (1 s) and only then resumed its 5 degree sweep from the old
    bearing, in whichever direction it had last swept, sometimes out to the end
    stop first. The boxes only obey AIM/FIRE, so this is laptop logic and needs
    no reflash.
    When no box has seen the player for local_search_s (the existing "Player
    lost" moment) every box now stops its jitter and searches: steps of
    search_st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
    [test_swarm.py]
2026-10-02 tools: jump benchmark in the simulator, with the recorded results
    tools/jump_bench.py times how fast the swarm tracker finds a player who
    jumps to another column on config.prototype.json: before the search after a
    full loss (reproduced by switching the search off), with it, and with a right
    or wrong expect() hint. Eight jumps, 20 jump moments each, because the result
    depends on where each box is in its ping cycle. It prints Markdown tables,
    --csv writes one row per trial, --timeline what each box does after a jump.
    docs/jump-bench-2026-10-02.md records the run: median first fix for a jump
    that skips a column 3.35-9.12 s before, 1.34-1.49 s with the search,
    0.84-0.90 s with the right hint; s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
    [jump_bench.py]
2026-10-02 docs: commit hashes quoted in the bench logs
    The two bench logs named commits by hashes that are no longer in the
    history. They now name the same commits by their current hashes.
2026-10-04 tracker: hold a player who stands still despite a static echo and missed pings
    On the boxes on 5 October 2026 a player standing still on a hole was lost 14
    times a minute and the cursor jumped by up to 1.2 m. The empty-room map had
    box 0 hearing something 0.62 m away at 30-35 degrees and box 2 0.66 m away at
    150 degrees: the inner ends of their arcs, most likely the middle box. From
    the game log and the code:
    - From the hole stood on, the player is 33-36 degrees from box 0. Every
    reading there at or beyond the mapped echo was taken as background, so
    box 0's readings of the player at 1.4 m were thrown away.
    - A few degrees further round, where the map has nothing, box 0 heard the
    objec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
    [stand_bench.py, test_swarm.py]
2026-10-04 results: V1 vs V2 reacquisition table and histogram for the report
    The field comparison of 3 October 2026 (three boxes, same calibration and
    field config): V1 = the tracker before the search after a full loss
    (results/jump-v1-3.csv, 305 s tracked, 70 losses), V2 = with it
    (results/jump-v2-1.csv, 112 s, 37 losses).
    - reacquire_table.md: reacquire time after a loss, median 0.51 -> 0.21 s
    (p = 0.016), mean 0.79 -> 0.47 s (p = 0.032), 90th percentile 2.25 ->
    1.12 s, longest 6.13 -> 2.45 s; losses longer than 2 s 10 % -> 3 %
    (p = 0.163, not significant with this many losses). One-sided permutation
    tests, 20 000 shuffles. Times resolved to about 0.1 s, the recording
    interval.
    - reacquir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
2026-10-13 window, cli, docs: one spot per player, zones in the CSV and headless output
    The window draws one spot per zone (cyan for player 1, amber for player 2),
    the dividing line and the player names; D lists both positions. In
    simulation the mouse moves the player of the half it is in. --record gains
    a zones column and the headless report a zones list, both empty for a
    single player whose values stay in the ordinary columns.
    README: how to run the four-box field with config.pvp.json and its own
    calibration file. Architecture: the zones section. Changelog entry.
2026-10-13 geometry: node_x maps node IDs to positions; the fourth box builds as node 3
    Node IDs followed the sorted x order, so a fourth box at 0.85 m would have
    renumbered the right box to node 3 and every mode switch would have meant a
    reflash. node_x lists the x of each node by NODE_ID (a permutation of
    left_x, right_x and extra_sensor_x) and is a layout field, so a saved
    calibration is invalidated when it changes. Default sweep arcs now follow
    position, not node number.
    config.pvp.json keeps the prototype boxes as nodes 0, 1, 2 and adds node 3
    at 0.85 m; zones (0, 1) and (2, 3). PlatformIO env node_fourth and the
    tracker_fourth Arduino sketch build it. The single-player field is untouched.
2026-10-20 bench: a Makefile for flashing the boxes and running the game
    The pio and python lines were hard to remember, and the box names are a
    trap: the builds are named from behind the boxes, the user names them from
    the player's side. `make left|middle|right|fourth` takes the user's names
    and picks the right build, finds the USB port, copies the private config
    when missing, prints the firmware commit, retries the upload once and opens
    the serial monitor. `make game`, `game-sim`, `game-pygame`, `tracker`,
    `tracker-pvp`, `tracker-sim`, `test`, `build`, `status`, `ports` and
    `update` cover the rest. `make` alone lists them.
2026-10-25 bench: fourth box setup guide, test and evidence targets, three-box PvP fallback
    docs/box4-setup.md: pin map (servo 33, TRIG 32, ECHO 34, sensor on 3V3,
    USB power, no battery), flashing with make fourth, bench checks B1-B3 and
    acceptance tests A1-A7 with pass criteria and evidence names for the test
    report. README links it from the player-versus-player section.
    Makefile: check (both suites, native firmware test, compile, smoke),
    calibrate and calibrate-pvp, record/record-pvp/game-record writing
    results/field/<date>-<LABEL>-*.csv, metrics over those CSVs, test targets
    print only the Ran/OK lines, status lists calibration files and recordings.
    config.pvp-3box.json and tracker-pvp3/game-pvp3: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
2026-10-29 battery: read the boxes' WM2 BATT broadcast, keep a level per box, show the lowest
    The firmware on main broadcasts WM2 BATT <node> <volts> <percent> once a
    second. protocol.parse returns Battery for it; SwarmController keeps the last
    report per box (10 s stale), Snapshot.battery carries (percent, volts, age)
    per box, battery_lowest() names the weakest. The window's box lines and the
    headless JSON show it; the simulator reports 100 % per box. Nothing is
    requested from a box and the firmware is unchanged.
2026-11-02 firmware: box 4 reports its USB supply as a full battery
    Box 4 runs from USB with GPIO39 left empty, so its reading of the floating
    pin came out as 0.54 V, 0 % and would show as the weakest box in the PvP
    HUD. node_fourth now builds with BATTERY_SENSE=0 and always reports
    5.00 V, 100 %; the other boxes are unchanged.
